ashcash63/Soil-Irrigation-System-Project/System Architecture Drawing.pdf

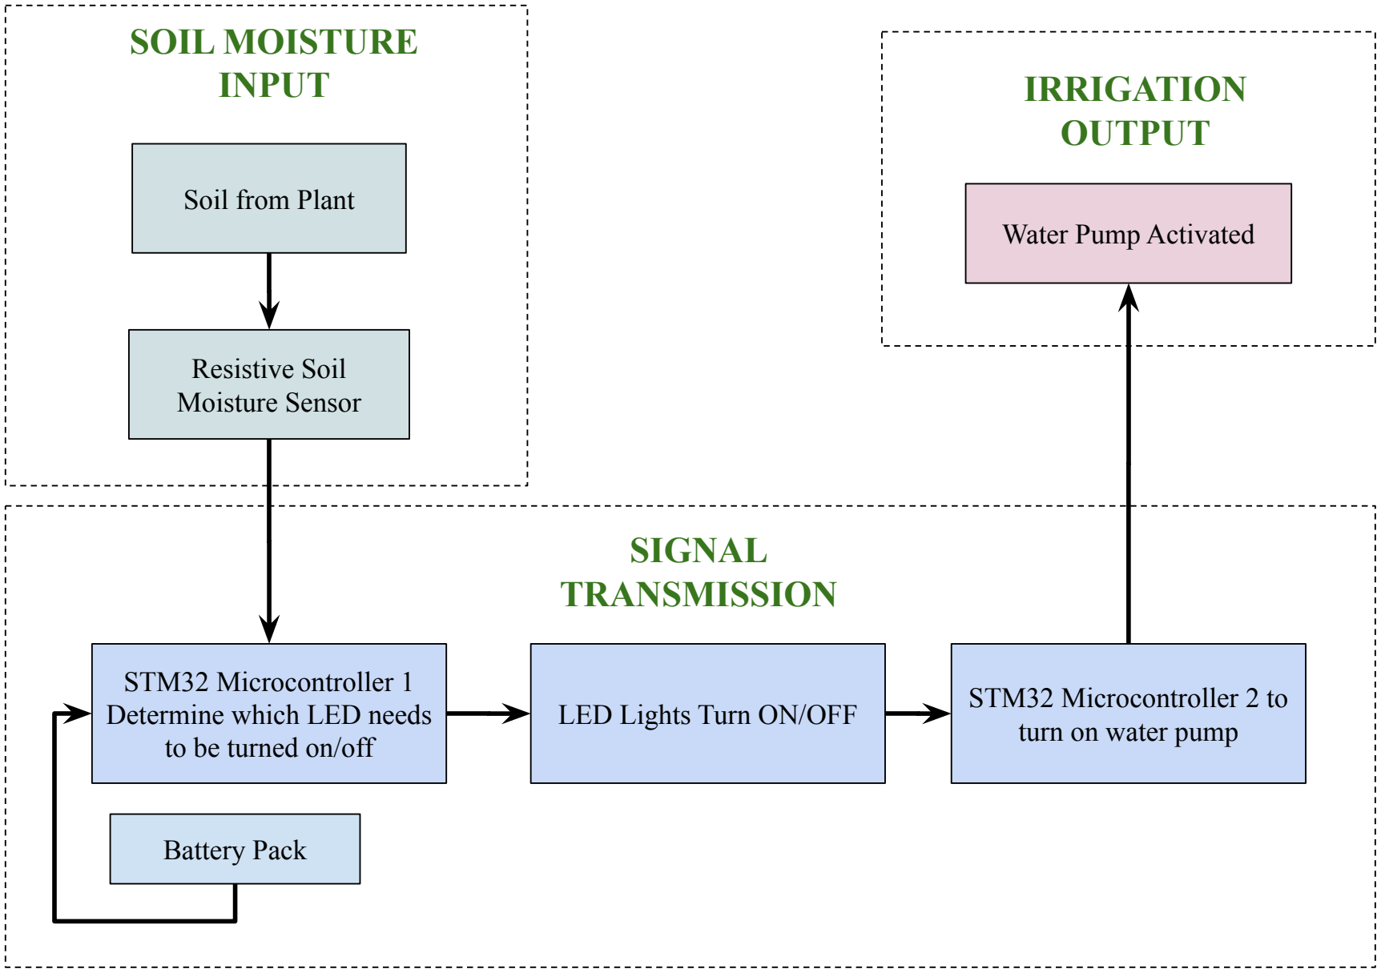
[picture p9: figure]
SOIL MOISTURE; INPUT; IRRIGATION; OUTPUT; Resistive Soil Moisture Sensor; Soil from Plant; STM32 Microcontroller 1 Determine which LED needs to be turned on/off; STM32 Microcontroller 2 to; Water Pump Activated; Battery Pack; SIGNAL TRANSMISSION

turn on water pump LED Lights Turn ON/OFF
