ashcash63/Soil-Irrigation-System-Project/First Version PinOut STM32.PNG

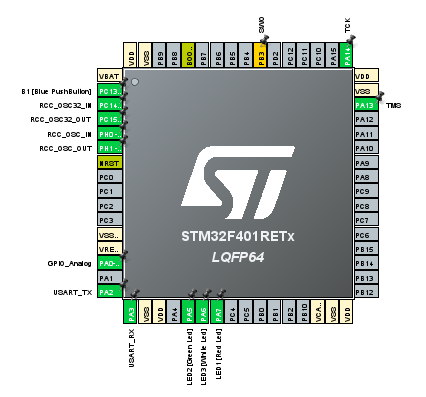
First Version PinOut STM32.PNG
