ashcash63/Soil-Irrigation-System-Project/Test Log Sheet.xlsx

Soil Irrigation System Test Log Sheet
Date | Time | Test Number | Version | Test Standard | Results | Pass/Fail
2024-11-16 | 18:02:00 | Test 1: Verifying Power Supply | Rev 1.0 | Voltage ±5% of expected levels | Power Supply working correctly LED turning ON | Pass
2024-11-18 | 17:32:00 | Test 4: Testing LED Indicators | Rev 1.0 | Turn ON Red LED using Push Buton | LEDs respond correctly | Pass
2024-11-19 | 18:45:00 | Test 4: Testing LED Indicators | Rev 2.0 | Turn ON Red LED using Push Button 1 and Turn OFF LED using Push Button 2 | LEDs respond correctly | Pass
2024-11-21 | 19:00:00 | Test 2: Testing Moisture Detection | Rev 1.0 | Dry: 0-341, Moist: 341-682, Saturated: 682+. Consistent readings across 3 trials for sandy, loamy, clay.
2024-11-21 | 19:00:00 | Test 3: Checking Water Pump Activation | Rev 1.0 | Pump activates for correct flow time after delay, consistent across soil types
2024-11-23 | 19:00:00 | Test 4: Testing LED Indicators | Rev 3.0 | Green: Sufficient moisture; White: Dry soil; Red: Pump active. LEDs must light correctly and respond consistently.
2024-11-23 | 19:00:00 | Test 5: Checking Energy Consumption | Rev 1.0 | Does not exceed 500 millijoules (mJ) during the full operation cycle.
