ashcash63/Soil-Irrigation-System-Project/Electrical Schematics.pdf

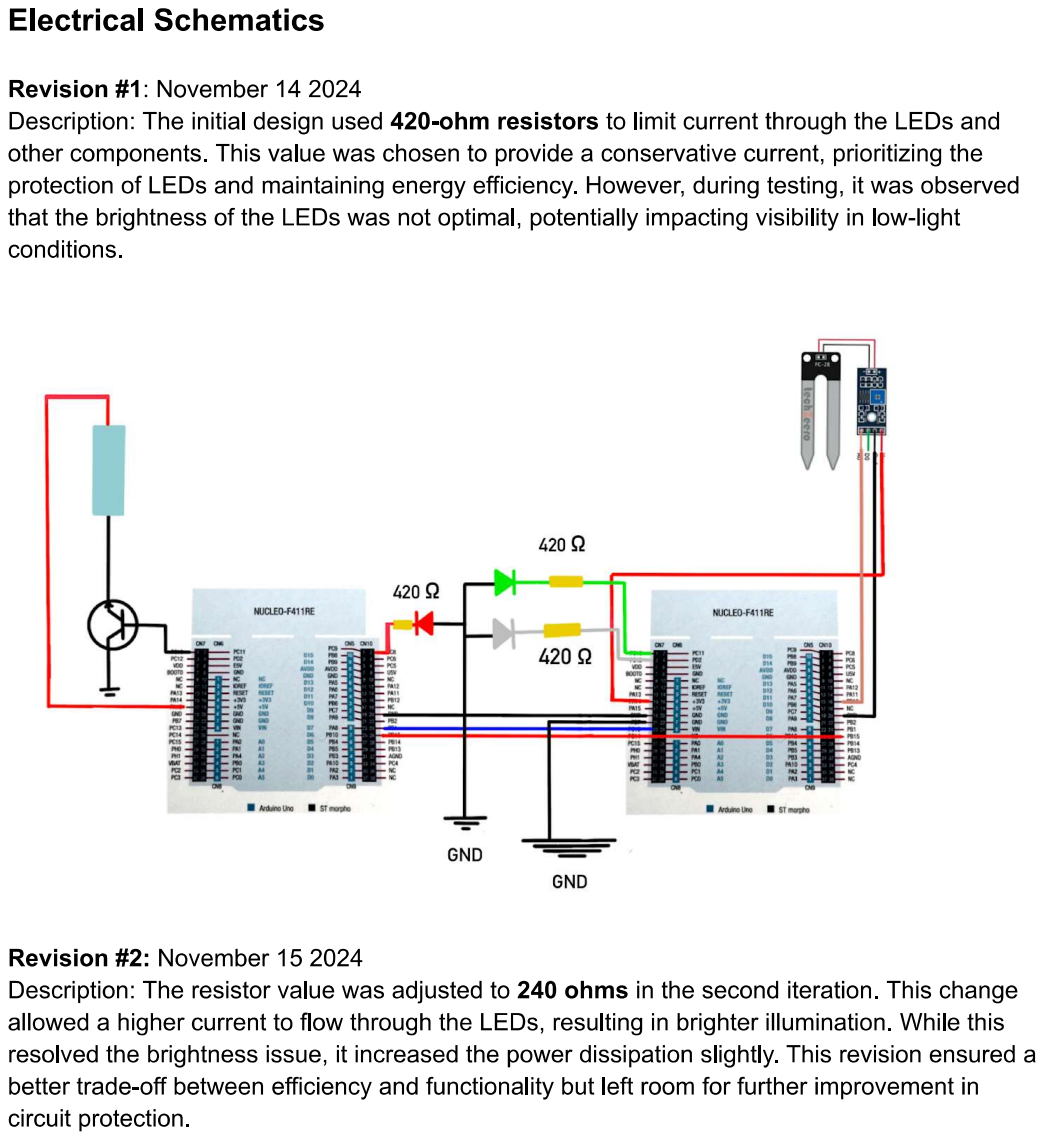
[picture p11: page 1]

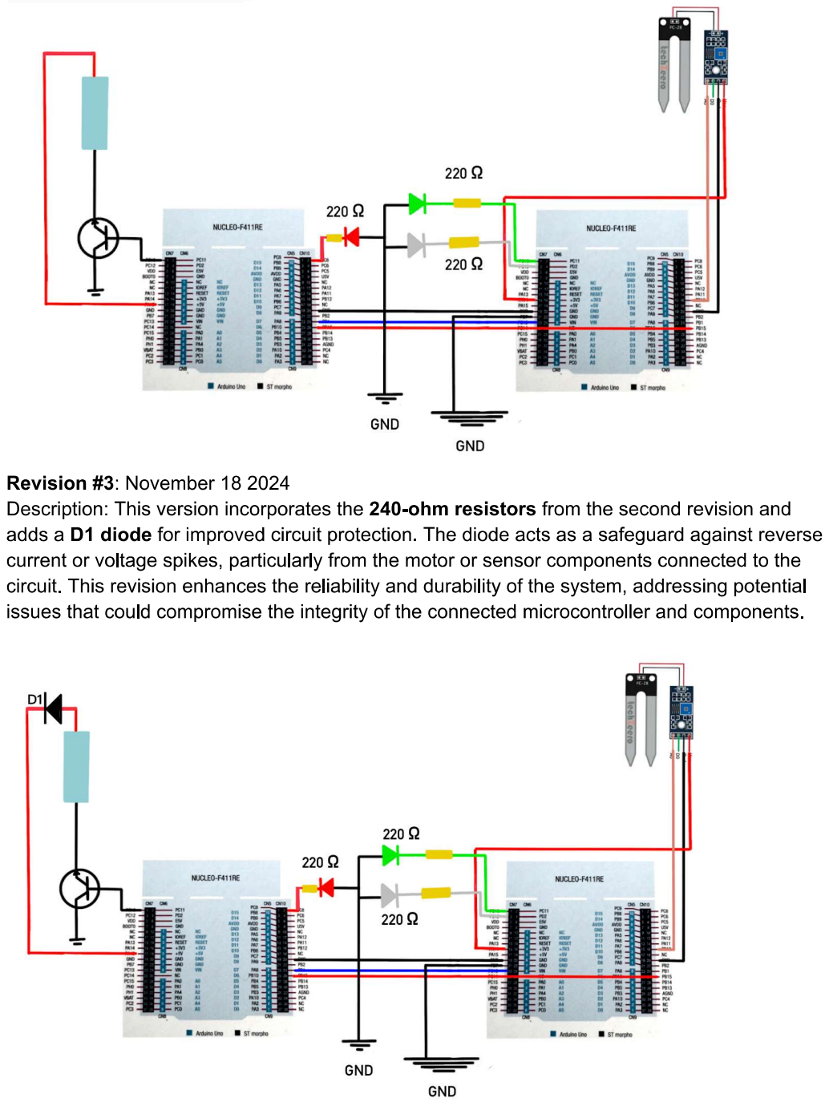
[picture p12: page 2]
