ashcash63/Soil-Irrigation-System-Project/Soil Irrigation System/Core/Src/recieving_main.c

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
/* Includes ------------------------------------------------------------------*/
#include "main.h"

/* USER CODE BEGIN PD */

#define k_sandy 0.1
#define k_clay 0.1
#define k_loamy 0.05


/* USER CODE END PD */

UART_HandleTypeDef huart1;
UART_HandleTypeDef huart2;
char soilType[50];
char potSize[20];
float permeability;
float potVolume;
float flowRate;
float flowTime;

void SystemClock_Config(void);
static void MX_GPIO_Init(void);
static void MX_USART1_UART_Init(void);
static void MX_USART2_UART_Init(void);
void UserInput(void);
/**
  * @brief  The application entry point.
  * @retval int
  */
int main(void)
{

  /* MCU Configuration--------------------------------------------------------*/

  /* Reset of all peripherals, Initializes the Flash interface and the Systick. */
  HAL_Init();

  /* Configure the system clock */
  SystemClock_Config();

  /* Initialize all configured peripherals */
  MX_GPIO_Init();
  MX_USART1_UART_Init();
  MX_USART2_UART_Init();
  UserInput();
  /* Infinite loop */
  /* USER CODE BEGIN WHILE */
  while (1)
    {
    /* USER CODE END WHILE */
	  if (HAL_GPIO_ReadPin(GPIOB, GPIO_PIN_4) == GPIO_PIN_SET) {
	                 HAL_GPIO_WritePin(GPIOB, GPIO_PIN_10, GPIO_PIN_SET);
	                 HAL_Delay(10000); // 10 seconds for demo purpose

	                 HAL_GPIO_WritePin(GPIOB, GPIO_PIN_8, GPIO_PIN_RESET);
	                 HAL_GPIO_WritePin(GPIOB, GPIO_PIN_10, GPIO_PIN_RESET);
	                 HAL_GPIO_WritePin(GPIOB, GPIO_PIN_9, GPIO_PIN_SET);
	                 HAL_GPIO_WritePin(GPIOA, GPIO_PIN_6, GPIO_PIN_SET);
	                 HAL_GPIO_WritePin(GPIOB, GPIO_PIN_5, GPIO_PIN_SET);
	                 HAL_Delay(flowTime);
	                 HAL_GPIO_WritePin(GPIOA, GPIO_PIN_6, GPIO_PIN_RESET);
	                 HAL_GPIO_WritePin(GPIOB, GPIO_PIN_5, GPIO_PIN_RESET);
	                 HAL_GPIO_WritePin(GPIOB, GPIO_PIN_9, GPIO_PIN_RESET);
	                 HAL_GPIO_WritePin(GPIOB, GPIO_PIN_8, GPIO_PIN_SET);
	             } else {
	                 HAL_GPIO_WritePin(GPIOB, GPIO_PIN_8, GPIO_PIN_SET);
	             }

    /* USER CODE BEGIN 3 */
  }
  /* USER CODE END 3 */
}

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
/* USER CODE BEGIN 4 */

void UserInput(void) {

	 strcpy(soilType, "loamy");
	 strcpy(potSize, "small");

	 if (strcmp(soilType, "sandy") == 0) {
	         permeability = 0.1;
	 } else if (strcmp(soilType, "clay") == 0) {
	         permeability = 0.1;
	 } else if (strcmp(soilType, "loamy") == 0) {
	         permeability = 0.05;
	 }

	 if (strcmp(potSize, "small") == 0) {
	         potVolume = 5;
	 } else if (strcmp(potSize, "medium") == 0) {
	         potVolume = 10;
	 } else if (strcmp(potSize, "large") == 0) {
	         potVolume = 15;
	 } else if (strcmp(potSize, "extra large") == 0) {
	         potVolume = 20;
	 }

	 flowRate = permeability * 100 * 1;
	 flowTime = 4000;

}

/* USER CODE END 4 */
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
