ashcash63/Soil-Irrigation-System-Project/(commit log)

2024-11-21 Added soil moisture sensor functionality
2024-11-21 STM32 Workspace Diagram
    Version 1.0.0 2024-11-20 Workspace Diagram
2024-11-24 Update and rename main.c to recieving_main.c
    Split code in between two main files, one for receiving STM32 Microcontroller and ono for the transmitting STM32 microcontroller.
2024-11-24 Create transmitting_main.c
    The code for the STM32 Controller that is connected to the soil sensor and is transmitting data to the first microcontroller
2024-11-25 Update recieving_main.c
    Instead of using UART for communication, trying to make communication between STM Microcontrollers with SPI instead
2024-11-25 Update transmitting_main.c
    Replacing UART communication with SPI communication to see if there is a better connection between both microcontrollers
