ashcash63/Soil-Irrigation-System-Project/(notices)

Notices in the files:
Soil Irrigation System/Core/Src/recieving_main.c:
Copyright (c) 2024 STMicroelectronics.
All rights reserved.
This software is licensed under terms that can be found in the LICENSE file
